slaesh/smahoo-hw/cpu-boards/esp32-pico-v3-02/inwall-relay-esp32.kicad_pcb

## KiCad design cpu-boards/esp32-pico-v3-02/inwall-relay-esp32.kicad_pcb (2023-01-14)

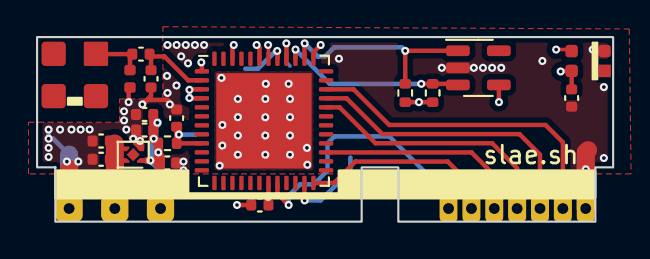
[picture p1: board inwall-relay-esp32.kicad_pcb from above]

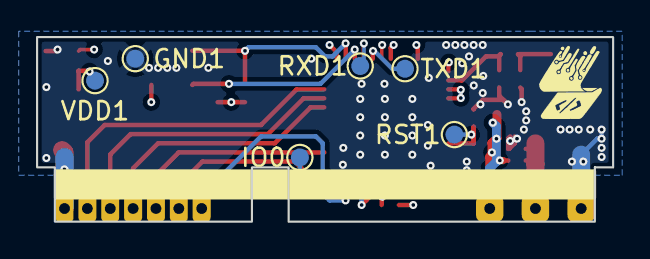
[picture p2: board inwall-relay-esp32.kicad_pcb from below]

Board: 4 copper layers, 32.0 x 10.3 mm, 26 parts (6 on the bottom side), 17 nets.

Parts:
C1, C2, C7: 1uF; C_0402_1005Metric
C3: 4.3nH; C_0402_1005Metric
C4: 0R; C_0402_1005Metric
C5: C; L_0402_1005Metric
C6, C8: 10uF; C_0402_1005Metric
C9, C10, C11: 100nF; C_0402_1005Metric
D1: WS2812B-2020; ws2812b-2020
GND1: TestPoint; TestPoint_Pad_D1.0mm
IO0: TestPoint; TestPoint_Pad_D1.0mm
J1: Conn_01x09_Male; inwall-relay-cpu
J2: ANTENNA; antenna_molex_479480001
R1, R2, R3: 10k; R_0402_1005Metric
RST1: TestPoint; TestPoint_Pad_D1.0mm
RXD1: TestPoint; TestPoint_Pad_D1.0mm
TXD1: TestPoint; TestPoint_Pad_D1.0mm
U1: ESP32-PICO-D4; QFN-48-1EP_7x7mm_P0.5mm_EP5.3x5.3mm
U2: NCP167; OnSemi_XDFN4-1EP_1.0x1.0mm_EP0.52x0.52mm
U3: 24AA02-OT; SOT-23-5
VDD1: TestPoint; TestPoint_Pad_D1.0mm

Connections:
BOARD_IO0: J1.4, U1.34 (IO5)
BOARD_IO1: J1.5, U1.33 (SD1)
BOARD_IO2: J1.6, U1.32 (SD0)
BOARD_IO4: J1.8, U1.24 (IO4)
BOARD_IO5: J1.9, U1.20 (IO13)
ESP_ANT: C3.1, C4.1, U1.2 (LNA_IN)
GND: C1.2, C2.2, C3.2, C5.1, C6.2, C7.2, C8.2, C9.2, C10.2, C11.2, D1.2 (VSS), GND1.1, J1.1, U1.49 (GND), U2.2 (GND), U3.2 (GND)
unnamed: C4.2, C5.2, J2.1
unnamed: C7.1, R1.2, RST1.1, U1.9 (EN)
unnamed: IO0.1, U1.23 (IO0)
unnamed: RXD1.1, U1.40 (U0RXD/IO3)
unnamed: TXD1.1, U1.41 (U0TXD/IO1)
SCL: R3.1, U1.38 (IO19), U3.1 (SCL)
SDA: R2.1, U1.39 (IO22), U3.3 (SDA)
VDD3V3: C2.1, C6.1, C9.1, C10.1, C11.1, D1.4 (VDD), J1.3, R1.1, R2.2, R3.2, U1.1 (VDDA), U1.3 (VDDA3P3), U1.4 (VDDA3P3), U1.19 (VDD3P3_RTC), U1.37 (VDD3P3_CPU), U1.43 (VDDA), U1.46 (VDDA), U2.1 (VOUT), U3.4 (VCC), VDD1.1
VIN: C1.1, C8.1, J1.2, U2.3 (/EN), U2.4 (VIN)
WS2812_DIN: D1.3 (DIN), U1.42 (IO21)
