slaesh/smahoo-hw/base-board/inwall-relay.kicad_pcb

## KiCad design base-board/inwall-relay.kicad_pcb (2023-01-14)

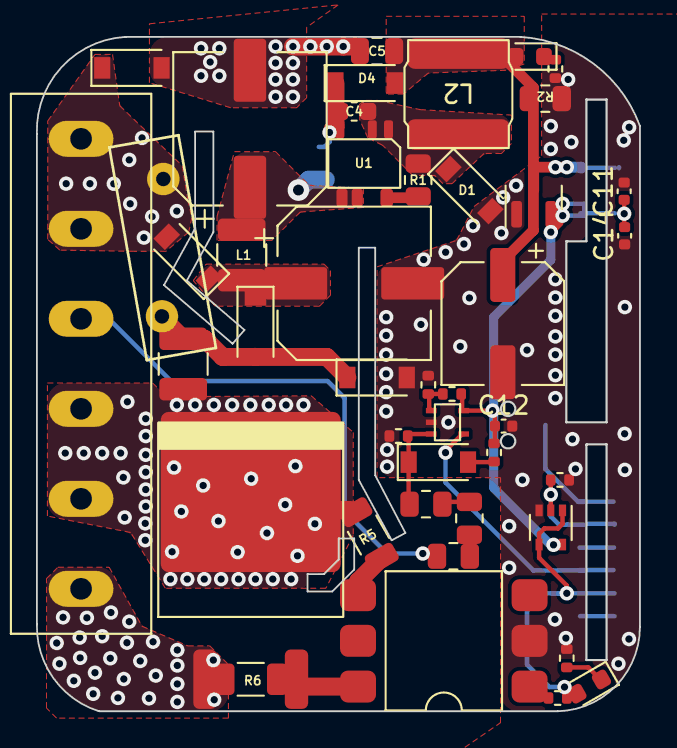
[picture p3: board inwall-relay.kicad_pcb from above]

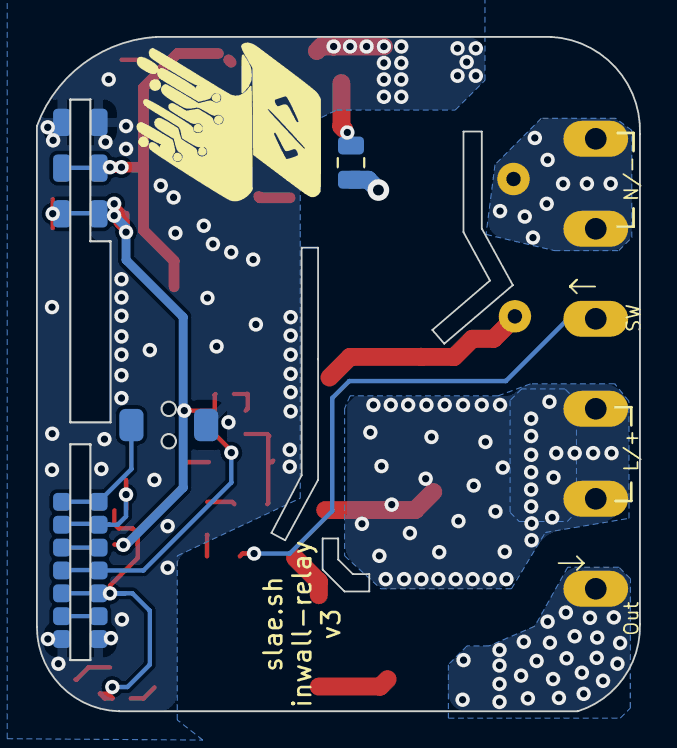
[picture p4: board inwall-relay.kicad_pcb from below]

Board: 2 copper layers, 33.5 x 37.5 mm, 46 parts (2 on the bottom side), 27 nets.

Parts:
C1, C3: 3.3uF; CP_Elec_8x10
C4: 1uF/16V; C_0603_1608Metric
C5: 22uF; C_0805_2012Metric
C8: 470uF; CP_Elec_6.3x7.7
C9: optional: 10pF / 500V; C_0805_2012Metric
C11: 22uF; C_0402_1005Metric
C12, C14: 100n; C_0402_1005Metric
D1: BAS21GWX; D_SOD-123
D2, D3, D4, D6, D7, D8: 1N4007; D_SOD-123
F1: Polyfuse; Fuse_1210_3225Metric
J1: IWR_CPU_MODULE; inwall-relay-cpu-female
J2: Conn_01x06_Female; WJ126-5.0
L1: 1mH; L_1210_3225Metric
L2: 470uH; L_6x6mm
LED1: blue; LED_0603_1608Metric
LED2: orange; LED_0603_1608Metric
Q1: BTA16-800B; D2PAK
R1: .3R; R_0805_2012Metric
R2: 1.5k; R_0805_2012Metric
R4, R20: 1.2k; R_0402_1005Metric
R5: 100R; R_1206_3216Metric
R6: 330R; R_1206_3216Metric
R10: 680R; R_0402_1005Metric
R11, R29, R30, R31, R32: 10k; R_0402_1005Metric
R26, R27, R28: 300k; R_0805_2012Metric
RV1: Varistor; RV_Disc_D12mm_W3.9mm_P7.5mm
SW1: SW_Push; TS-1088C-02526
U1: BP2525; sot33-5a
U2: MOC3063M; SMDIP-6_W9.53mm
U3: APE8865N-15-HF-3; SOT-23
U6: 74LVC1G80; SOT-353_SC-70-5
U7: TC75S56; SSOP-5-0.65

Connections:
/VIN_L_FUSED: D2.2 (A), D3.1 (K), F1.2, RV1.1
BOARD_IO1: J1.5, LED2.2 (A), R10.1, U6.1 (D), U6.4 (~Q)
BOARD_IO2: J1.6, U7.4
BOARD_IO4: J1.8, R11.2, U6.2 (C)
BOARD_IO5: J1.9, SW1.2
BP25xx_GND: C4.2, D1.1 (K), L2.1, R1.1, U1.1 (GND), U1.2 (SEL)
D: C3.1, C9.1, L1.2, U1.4 (DRAIN)
GND: C1.2, C3.2, C5.2, C8.2, C11.2, C12.2, C14.1, D1.2 (A), D3.2 (A), D7.2 (A), J1.1, R2.1, R4.2, R11.1, R20.2, R30.2, R32.2, SW1.1, U2.2, U3.1 (GND), U6.3 (GND), U7.2 (V-)
L_OUT: J2.6, Q1.1 (A1), R6.1
unnamed: C4.1, C9.2, D4.1 (K), U1.3 (VCC)
unnamed: D8.2 (A), R29.2
unnamed: D8.1 (K), R28.1, R30.1, U7.3 (-)
unnamed: LED1.1 (K), R4.1
unnamed: LED2.1 (K), R20.1
unnamed: R10.2, U2.1
unnamed: R26.1, R27.2
unnamed: R27.1, R28.2
unnamed: R1.2, U1.5 (CS)
unnamed: R31.2, R32.1, U7.1 (+)
TRIAC_EN1: Q1.3 (G), R6.2, U2.6
TRIAC_EN2: R5.1, U2.4
VDD3V3: C11.1, C12.1, C14.2, J1.3, R29.1, R31.1, U3.2 (VO), U6.5 (VCC), U7.5 (V+)
VDD5: C5.1, C8.1, D4.2 (A), J1.2, L2.2, LED1.2 (A), R2.2, U3.3 (VI)
VIN_L: F1.1, J2.4, J2.5, Q1.2 (A2), R5.2
VIN_L+: C1.1, D2.1 (K), D6.1 (K), L1.1
VIN_N: D6.2 (A), D7.1 (K), J2.1, J2.2, RV1.2
VIN_SWITCH: J2.3, R26.2
