slaesh/smahoo-hw/(threads)

Thread 1 (2023-04-19):

Full parts list?

TheAtomAnt, 2023-04-19:
Hi there! This is a great project and I'm using it to learn. I am wondering, is there a full detailed bom available? I can see some details but not all for each individual part.

Like RV1, or C1. For C1 I can see:  3.3uF	C_Polarized	my-stuff:CP_Elec_8x10	Polarized capacitor
but I can't see the voltages required.

Thanks for making this public, it's fun to learn about.
